barn53/wordclock-11x10-4/README.md

# wordclock-11x10-4
Wordclock project with 11x10 letter display + 4 minute identifier

# KiCad dependencies:

https://github.com/gerdmuller/barn53-kicad-library.git

https://github.com/Digi-Key/digikey-kicad-library.git
