barn53/wordclock-11x10-4/TODO.md

# TODO:

## 50x50cm clock
- Mount PBC to the reflector with screws
- Tinted Plexiglass®
- PCB new design
  - with screw holes (maybe only 3 per panel)
    - controller panel with 2 mounting holes also at the bottom
  - New USB connector (through hole)
  - Radar Module upside down

## 18x18cm clock
- Design 18x18cm clock for desk e.g. usage
- Tinted Plexiglass®
- PCB - discrete with ESP8285?
- 3mm WS2812?
- also 3D printed reflector?
- Mount PCB with screws
- can stand on desk or hang on wall
