barn53/wordclock-11x10-4/artwork/Wordclock Panel 1 Schematic.pdf

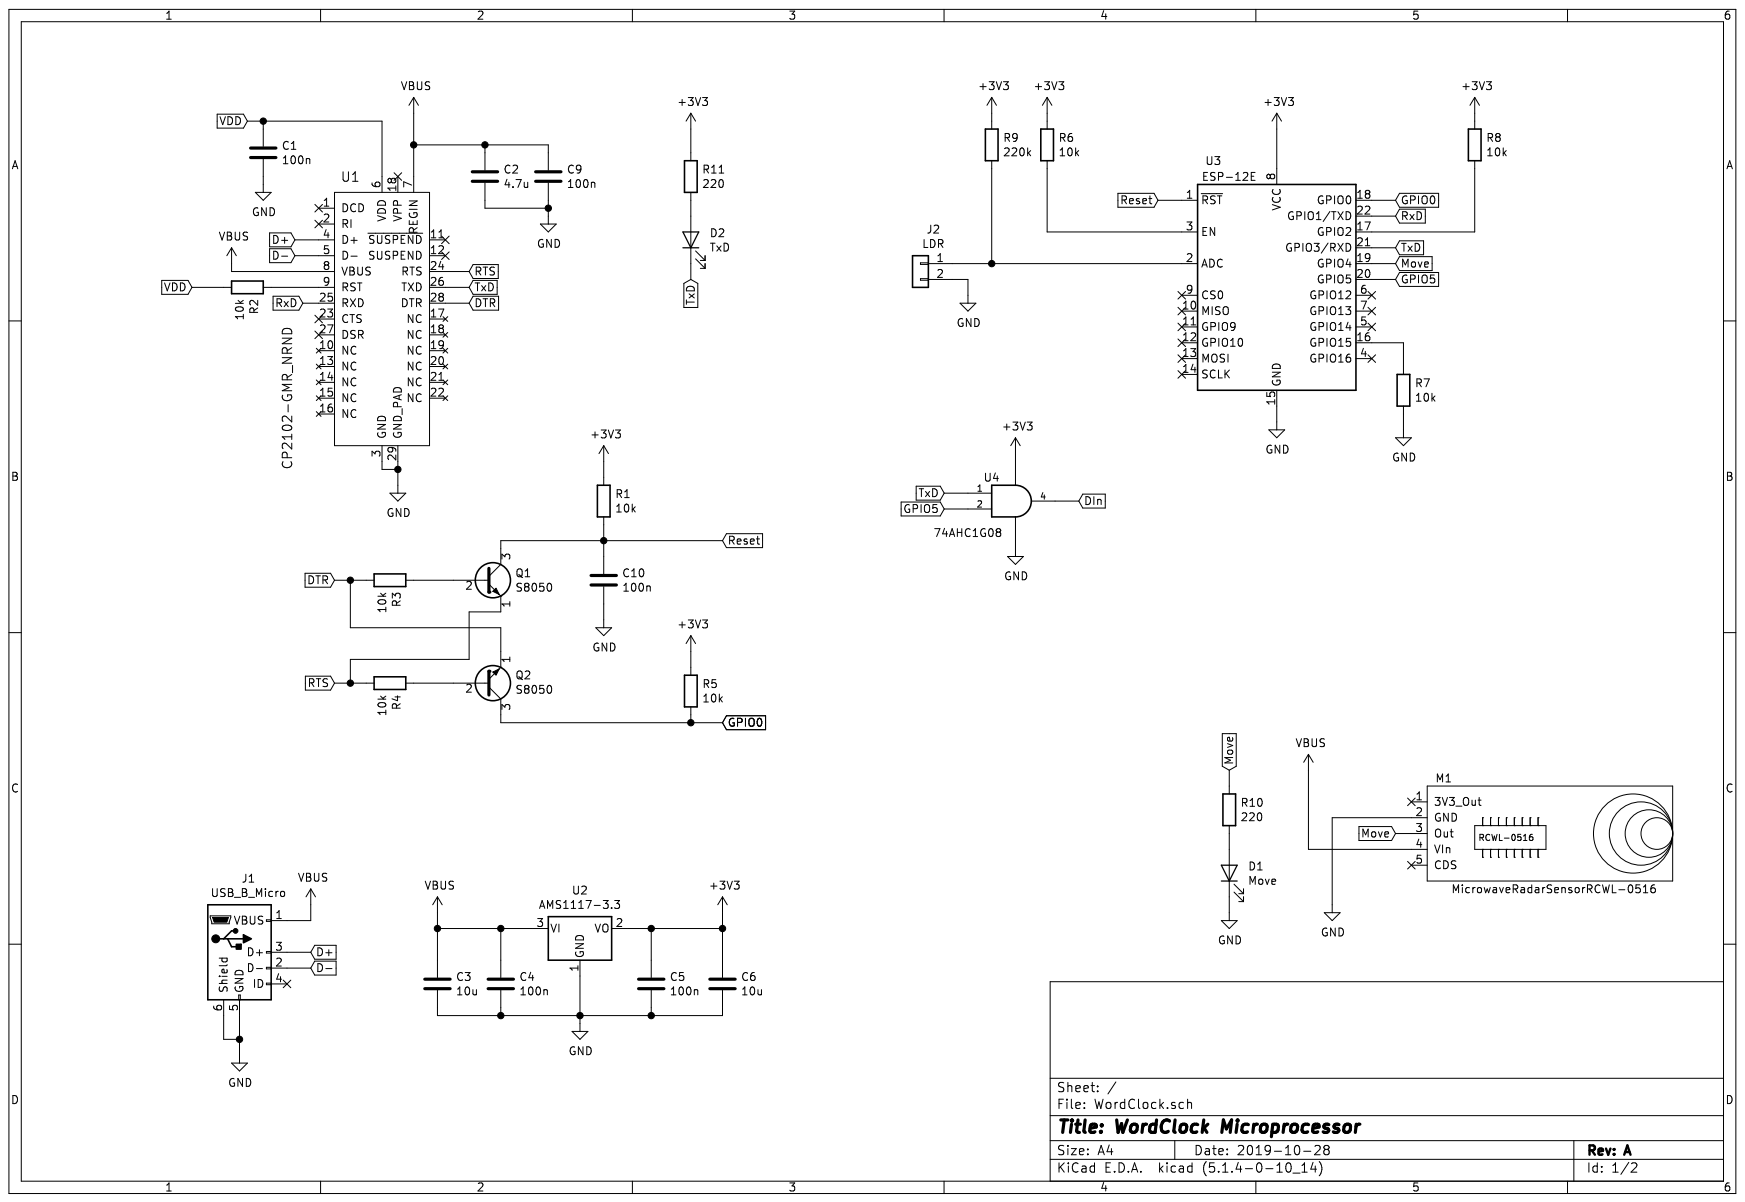
[picture p1: page 1]

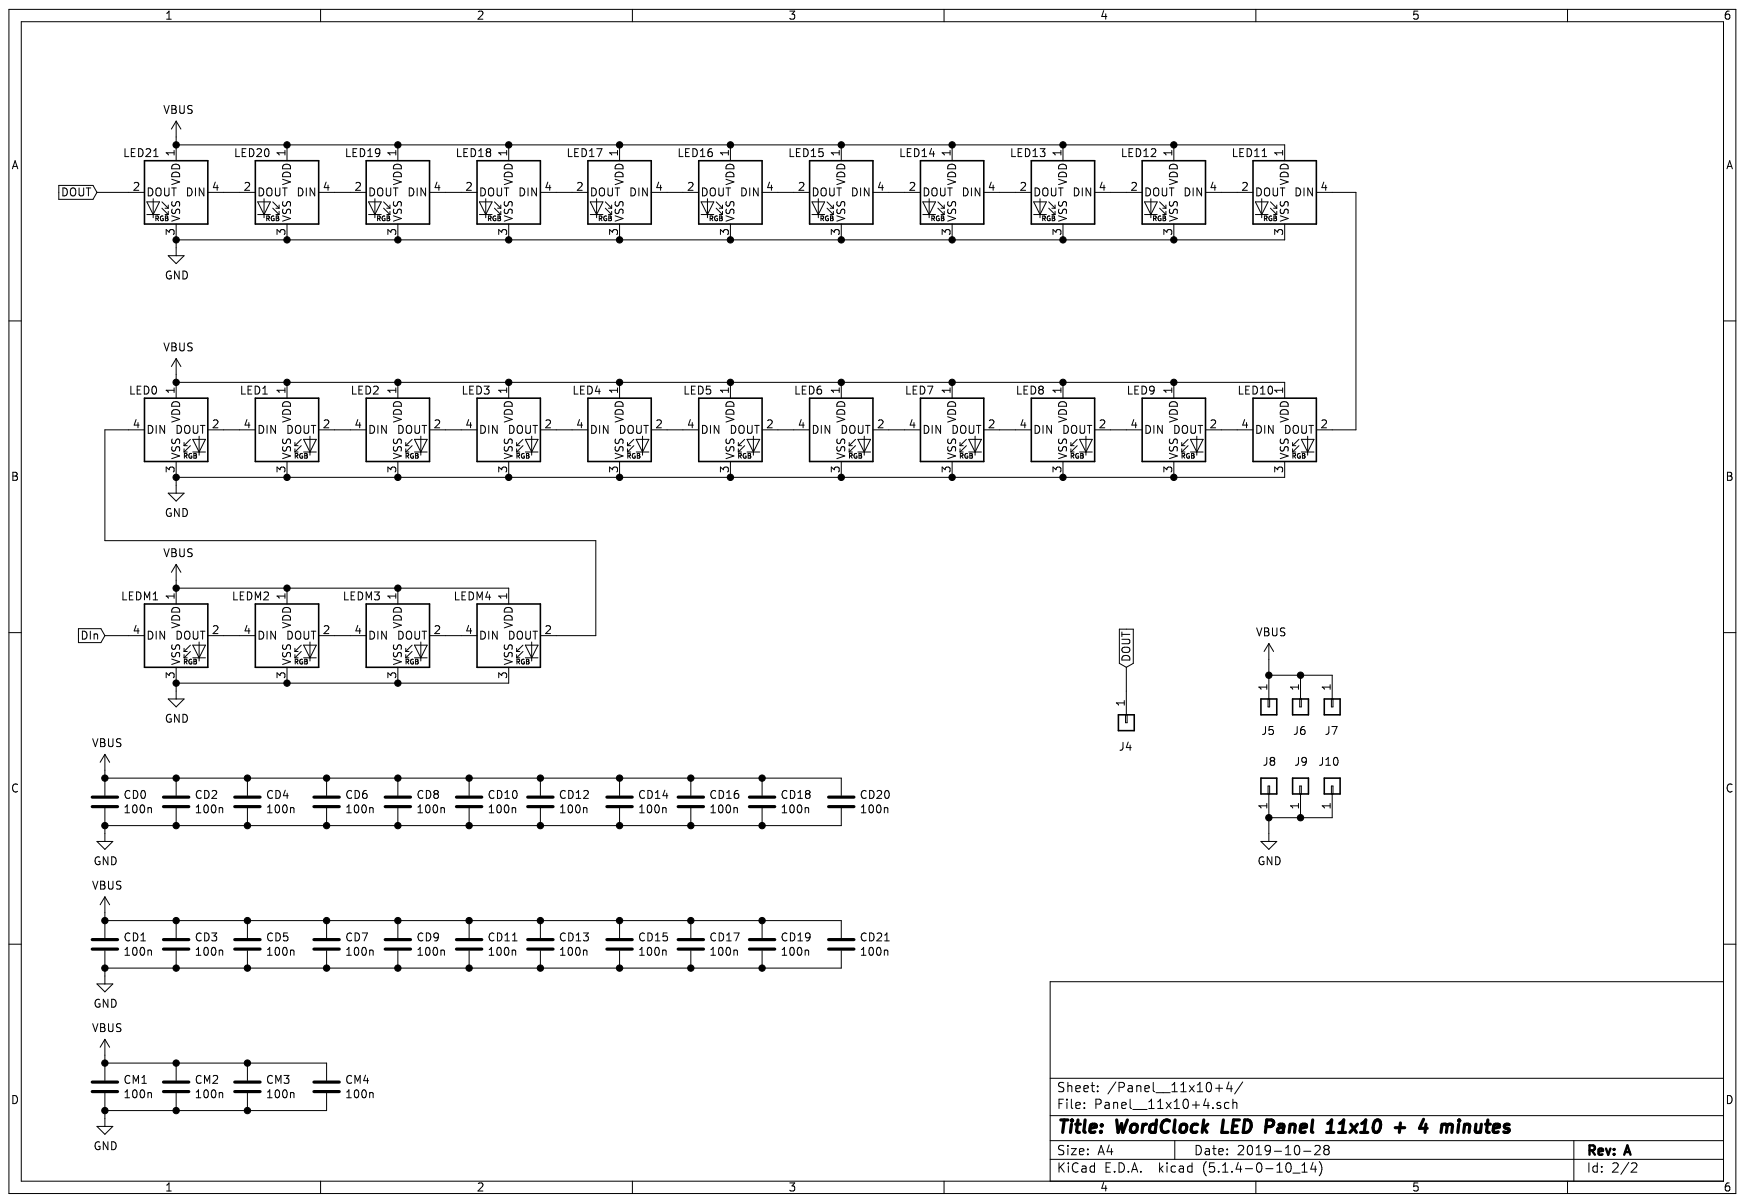
[picture p2: page 2]
