barn53/wordclock-11x10-4/artwork/Wordclock Panel 2 Schematic.pdf

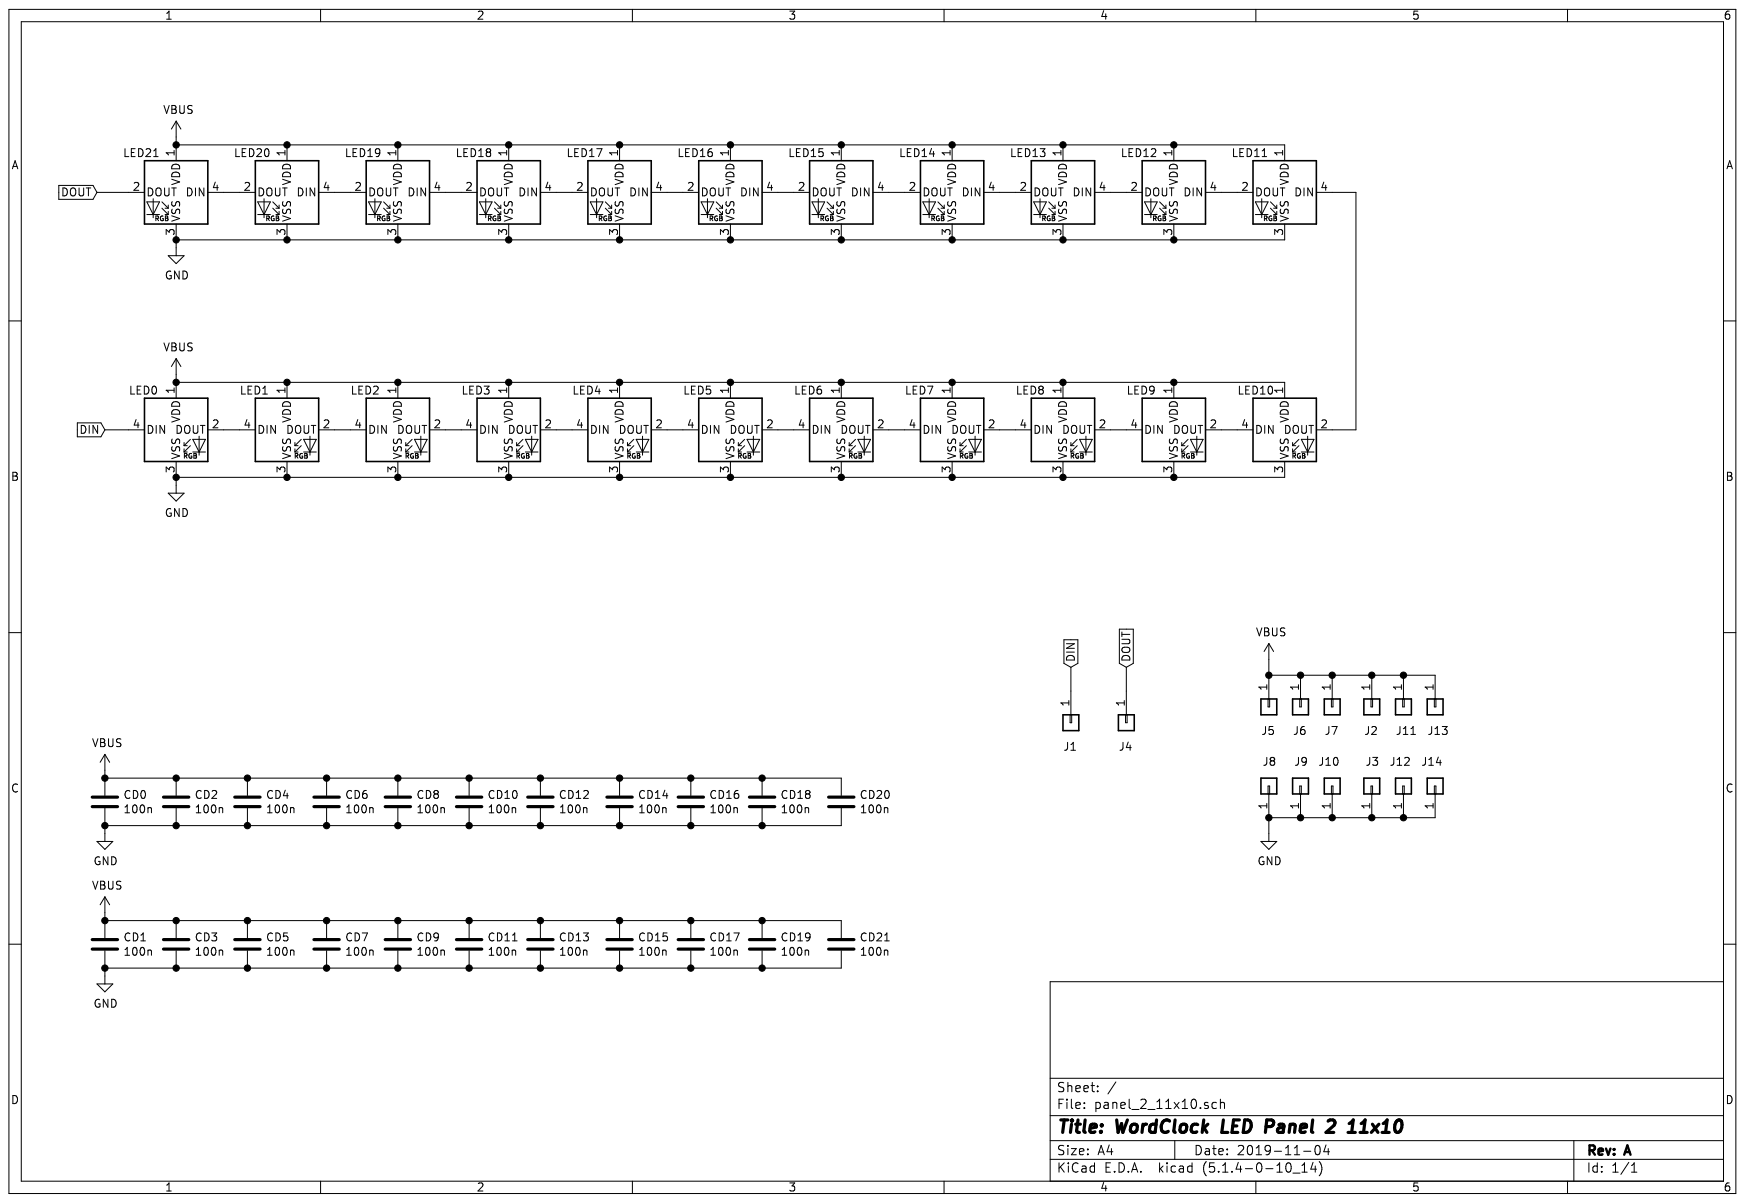
[picture p3: page 1]
