barn53/wordclock-11x10-4/kicad/controller/controller.kicad_pcb

## KiCad design kicad/controller/controller.kicad_pcb (2019-11-19)

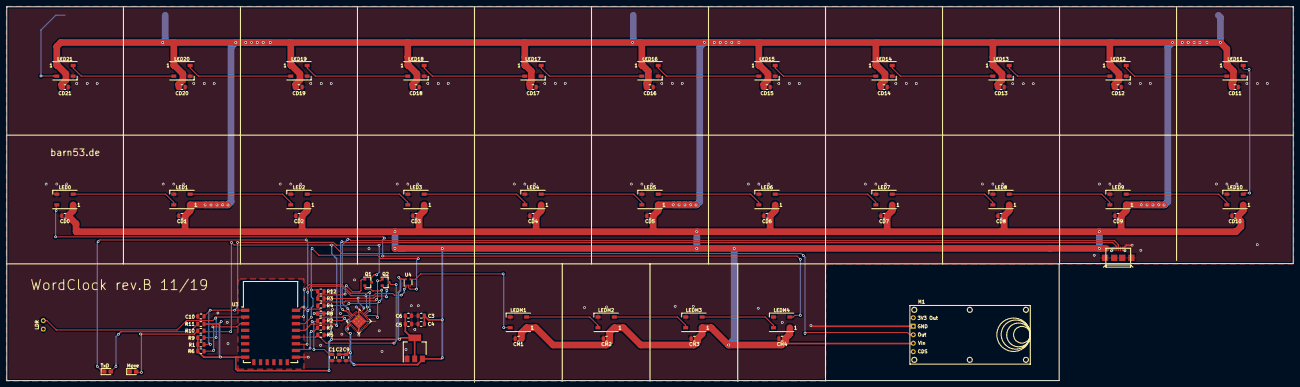
[picture p4: board controller.kicad_pcb from above]

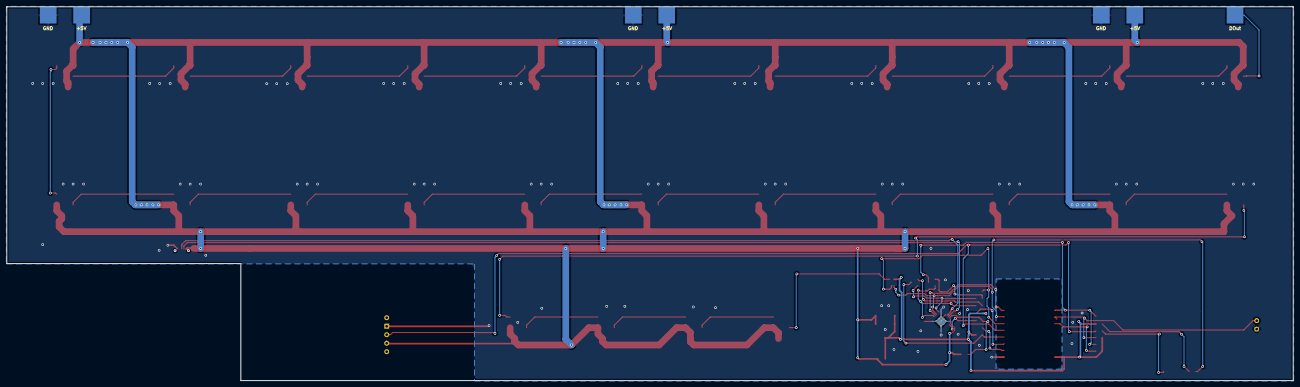
[picture p5: board controller.kicad_pcb from below]

Board: 2 copper layers, 384.8 x 111.8 mm, 90 parts (7 on the bottom side), 50 nets.

Parts:
C1, C4, C5, C9, C10: 100n; C_0805_2012Metric
C2: 4.7u; C_0805_2012Metric
C3, C6: 10u; C_0805_2012Metric
CD0, CD1, CD2, CD3, CD4, CD5, CD6, CD7, CD8, CD9, CD10, CD11, CD12, CD13, CD14, CD15, CD16, CD17, CD18, CD19, CD20, CD21: 100n; C_0805_2012Metric
CM1, CM2, CM3, CM4: 100n; C_0805_2012Metric
D1: Move; LED_0805_2012Metric_Castellated
D2: TxD; LED_0805_2012Metric_Castellated
J1: USB_B_Micro; MicroUSB_1
J2: LDR; ThroughHolePin1x2
J4: DOut; PCBSolderConnector
J5, J6, J7: +5V; PCBSolderConnector
J8, J9, J10: GND; PCBSolderConnector
LED0, LED1, LED2, LED3, LED4, LED5, LED6, LED7, LED8, LED9, LED10, LED11, LED12, LED13, LED14, LED15, LED16, LED17, LED18, LED19, LED20, LED21: WS2812B; LED_WS2812B_PLCC4_5.0x5.0mm_P3.2mm
LEDM1, LEDM2, LEDM3, LEDM4: WS2812B; LED_WS2812B_PLCC4_5.0x5.0mm_P3.2mm
M1: MicrowaveRadarSensorRCWL-0516
Q1, Q2: S8050_J3Y; SOT-23
R1, R2, R3, R4, R5, R6, R7, R8, R12: 10k; R_0805_2012Metric
R9: 220k; R_0805_2012Metric
R10, R11: 220; R_0805_2012Metric
U1: CP2102-GMR_NRND; QFN-28-1EP_5x5mm_P0.5mm_EP3.35x3.35mm_ThermalVias
U2: AMS1117-3.3; SOT-223-3_TabPin2
U3: ESP-12E
U4: 74AHC1G08; SOT-353_SC-70-5

Connections:
+3V3: C5.1, C6.1, R1.1, R5.1, R6.1, R8.1, R9.1, R11.1, U2.2, U3.8, U4.5
D+: J1.3, U1.4
D-: J1.2, U1.5
DIn: LEDM1.4, U4.4
DOUT: J4.1, LED21.2
DTR: Q2.2, R3.2, U1.28
GND: C1.2, C2.2, C3.2, C4.2, C5.2, C6.2, C9.2, C10.2, CD0.2, CD1.2, CD2.2, CD3.2, CD4.2, CD5.2, CD6.2, CD7.2, CD8.2, CD9.2, CD10.2, CD11.2, CD12.2, CD13.2, CD14.2, CD15.2, CD16.2, CD17.2, CD18.2, CD19.2, CD20.2, CD21.2, CM1.2, CM2.2, CM3.2, CM4.2, D1.1, J1.5, J1.6, J2.2, J8.1, J9.1, J10.1, LED0.3, LED1.3, LED2.3, LED3.3, LED4.3, LED5.3, LED6.3, LED7.3, LED8.3, LED9.3, LED10.3, LED11.3, LED12.3, LED13.3, LED14.3, LED15.3, LED16.3, LED17.3, LED18.3, LED19.3, LED20.3, LED21.3, LEDM1.3, LEDM2.3, LEDM3.3, LEDM4.3, M1.2, R7.2, R12.2, U1.3, U1.29, U2.1, U3.15, U4.3
GPIO0: Q2.3, R5.2, U3.18
GPIO5: R12.1, U3.20, U4.2
Move: M1.3, R10.1, U3.19
unnamed: D1.2, R10.2
unnamed: D2.2, R11.2
unnamed: J2.1, R9.2, U3.2
unnamed: LED0.2, LED1.4
unnamed: LED0.4, LEDM4.2
unnamed: LED1.2, LED2.4
unnamed: LED2.2, LED3.4
unnamed: LED3.2, LED4.4
unnamed: LED4.2, LED5.4
unnamed: LED5.2, LED6.4
unnamed: LED6.2, LED7.4
unnamed: LED7.2, LED8.4
unnamed: LED8.2, LED9.4
unnamed: LED10.2, LED11.4
unnamed: LED9.2, LED10.4
unnamed: LED11.2, LED12.4
unnamed: LED12.2, LED13.4
unnamed: LED13.2, LED14.4
unnamed: LED14.2, LED15.4
unnamed: LED15.2, LED16.4
unnamed: LED16.2, LED17.4
unnamed: LED17.2, LED18.4
unnamed: LED18.2, LED19.4
unnamed: LED19.2, LED20.4
unnamed: LED20.2, LED21.4
unnamed: LEDM1.2, LEDM2.4
unnamed: LEDM2.2, LEDM3.4
unnamed: LEDM3.2, LEDM4.4
unnamed: Q1.1, R3.1
unnamed: Q2.1, R4.1
unnamed: R2.1, U1.9
unnamed: R6.2, U3.3
unnamed: R7.1, U3.16
unnamed: R8.2, U3.17
RTS: Q1.2, R4.2, U1.24
Reset: C10.1, Q1.3, R1.2, U3.1
RxD: U1.25, U3.22
TxD: D2.1, U1.26, U3.21, U4.1
VBUS: C2.1, C3.1, C4.1, C9.1, CD0.1, CD1.1, CD2.1, CD3.1, CD4.1, CD5.1, CD6.1, CD7.1, CD8.1, CD9.1, CD10.1, CD11.1, CD12.1, CD13.1, CD14.1, CD15.1, CD16.1, CD17.1, CD18.1, CD19.1, CD20.1, CD21.1, CM1.1, CM2.1, CM3.1, CM4.1, J1.1, J5.1, J6.1, J7.1, LED0.1, LED1.1, LED2.1, LED3.1, LED4.1, LED5.1, LED6.1, LED7.1, LED8.1, LED9.1, LED10.1, LED11.1, LED12.1, LED13.1, LED14.1, LED15.1, LED16.1, LED17.1, LED18.1, LED19.1, LED20.1, LED21.1, LEDM1.1, LEDM2.1, LEDM3.1, LEDM4.1, M1.4, U1.7, U1.8, U2.3
VDD: C1.1, R2.2, U1.6
