barn53/wordclock-11x10-4/source/src/largevectors.h

#pragma once
#include "largedigits.h"
#include <Arduino.h>
using namespace std;

// clang-format off
vector<bool> LargeDigits::m_0 = {
// 0 1 2 3 4 5 6 7 8 9 10
   0,0,0,0,0,0,0,0,0,0,0,   // 0
   0,1,1,1,0,0,0,0,0,0,0,   // 1
   1,0,0,0,1,0,0,0,0,0,0,   // 2
   1,0,0,0,1,0,0,0,0,0,0,   // 3
   1,0,0,0,1,0,0,0,0,0,0,   // 4
   1,0,0,0,1,0,0,0,0,0,0,   // 5
   1,0,0,0,1,0,0,0,0,0,0,   // 6
   1,0,0,0,1,0,0,0,0,0,0,   // 7
   0,1,1,1,0,0,0,0,0,0,0,   // 8
   0,0,0,0,0,0,0,0,0,0,0,   // 9
};

vector<bool> LargeDigits::m_1 = {
// 0 1 2 3 4 5 6 7 8 9 10
   0,0,0,0,0,0,0,0,0,0,0,   // 0
   0,0,1,0,0,0,0,0,0,0,0,   // 1
   0,1,1,0,0,0,0,0,0,0,0,   // 2
   1,1,1,0,0,0,0,0,0,0,0,   // 3
   0,0,1,0,0,0,0,0,0,0,0,   // 4
   0,0,1,0,0,0,0,0,0,0,0,   // 5
   0,0,1,0,0,0,0,0,0,0,0,   // 6
   0,0,1,0,0,0,0,0,0,0,0,   // 7
   1,1,1,1,1,0,0,0,0,0,0,   // 8
   0,0,0,0,0,0,0,0,0,0,0,   // 9
};

vector<bool> LargeDigits::m_2 = {
// 0 1 2 3 4 5 6 7 8 9 10
   0,0,0,0,0,0,0,0,0,0,0,   // 0
   0,1,1,1,0,0,0,0,0,0,0,   // 1
   1,0,0,0,1,0,0,0,0,0,0,   // 2
   0,0,0,0,1,0,0,0,0,0,0,   // 3
   0,0,0,1,0,0,0,0,0,0,0,   // 4
   0,0,1,0,0,0,0,0,0,0,0,   // 5
   0,1,0,0,0,0,0,0,0,0,0,   // 6
   1,0,0,0,0,0,0,0,0,0,0,   // 7
   1,1,1,1,1,0,0,0,0,0,0,   // 8
   0,0,0,0,0,0,0,0,0,0,0,   // 9
};

vector<bool> LargeDigits::m_3 = {
// 0 1 2 3 4 5 6 7 8 9 10
   0,0,0,0,0,0,0,0,0,0,0,   // 0
   0,1,1,1,0,0,0,0,0,0,0,   // 1
   1,0,0,0,1,0,0,0,0,0,0,   // 2
   0,0,0,0,1,0,0,0,0,0,0,   // 3
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
   0,0,1,1,0,0,0,0,1,1,0,   // 2
   0,0,1,1,0,0,0,0,1,1,0,   // 3
   0,0,0,0,0,0,0,1,1,0,0,   // 4
   0,0,0,0,0,1,1,0,0,0,0,   // 5
   0,0,0,0,1,1,0,0,0,0,0,   // 6
   0,0,0,0,0,0,0,0,0,0,0,   // 7
   0,0,0,0,1,1,0,0,0,0,0,   // 8
   0,0,0,0,1,1,0,0,0,0,0,   // 9
};

// clang-format on
