barn53/wordclock-11x10-4/source/src/wifi.cpp

#include "wifi.h"
#include "secrets.h"

#include <Arduino.h>
#include <ESP8266WiFi.h>

void wifiSleep()
{
    WiFi.disconnect();
    WiFi.mode(WIFI_OFF);
    WiFi.forceSleepBegin();
    delay(1);
}
void wifiWake()
{
    WiFi.forceSleepWake();
    delay(1);
    WiFi.persistent(false);
    WiFi.mode(WIFI_STA);
}

void setupWiFi()
{
    wifiWake();

    WiFi.begin(ssid, password);
    WiFi.hostname(hostname);

    Serial.print("Connecting ");
    while (WiFi.status() != WL_CONNECTED) {
        Serial.print(".");
        delay(100);
    }

    Serial.printf("\nConnected\n IP address: %s\n", WiFi.localIP().toString().c_str());
    Serial.printf(" Hostname: %s\n", WiFi.hostname().c_str());
}
