barn53/wordclock-11x10-4/(commit log)

2019-11-03 PCB routed
    [Panel__11x10+4.sch, WordClock.kicad_pcb, WordClock.sch]
2019-11-03 added kicad gitignore
2019-11-04 updated pcb with new barn53-kicad path
    [WordClock.kicad_pcb]
2019-11-04 added panel 2 with 11x10 LEDs
    [panel_2_11x10.kicad_pcb, panel_2_11x10.sch]
2019-11-04 C3+C6 as 0805 instead of 1206
    [Panel__11x10+4.sch, WordClock.kicad_pcb, WordClock.sch]
2019-11-05 added LEDs, CP2102 45°
    [Panel__11x10+4.sch, WordClock.kicad_pcb, WordClock.sch]
2019-11-08 added AND gate to disable WS2812 DIn when flashing
    [Panel__11x10+4.sch, WordClock.kicad_pcb, WordClock.sch]
2019-11-10 pcb work
    [WordClock.kicad_pcb, WordClock.sch, panel_2_11x10.kicad_pcb]
2019-11-12 added schematics as .pdf
2019-11-19 painful error!
    Q1 and Q2 had the wrong pins with footprint SO-23!!!!! Added new S8050_J3 Symbol in barn32-kicad library with correct pinning.
    [Panel__11x10+4.sch, WordClock.kicad_pcb, WordClock.sch]
2019-11-19 Added missing pull down resistor
    Aaaaaargh!
    [Panel__11x10+4.sch, WordClock.kicad_pcb, WordClock.sch]
2020-01-03 Added letter matrix 11x10+4 for 500mm size
2020-01-13 updated kicad structure
    [controller.kicad_pcb, controller.sch, controller_leds.sch, led.kicad_pcb, led.sch, small.kicad_pcb, small.sch, small_leds.sch]
